mich-j/EMG_HID_mouse/schemat.pdf

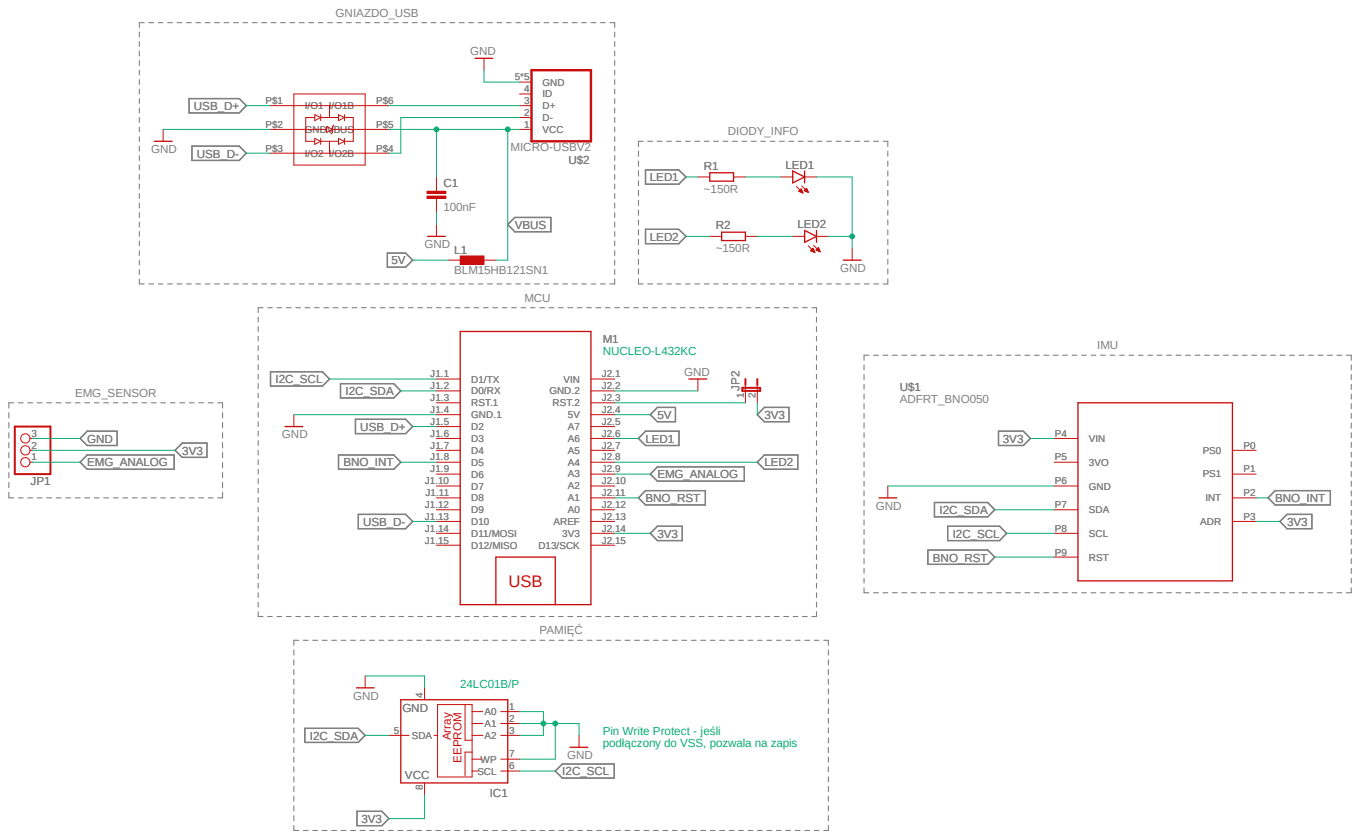
[picture p8: page 1]

Pin Write Protect - jeśli
podłączony do VSS, pozwala na zapis
GND
I2C_SCL
