mich-j/EMG_HID_mouse/PCB.pdf

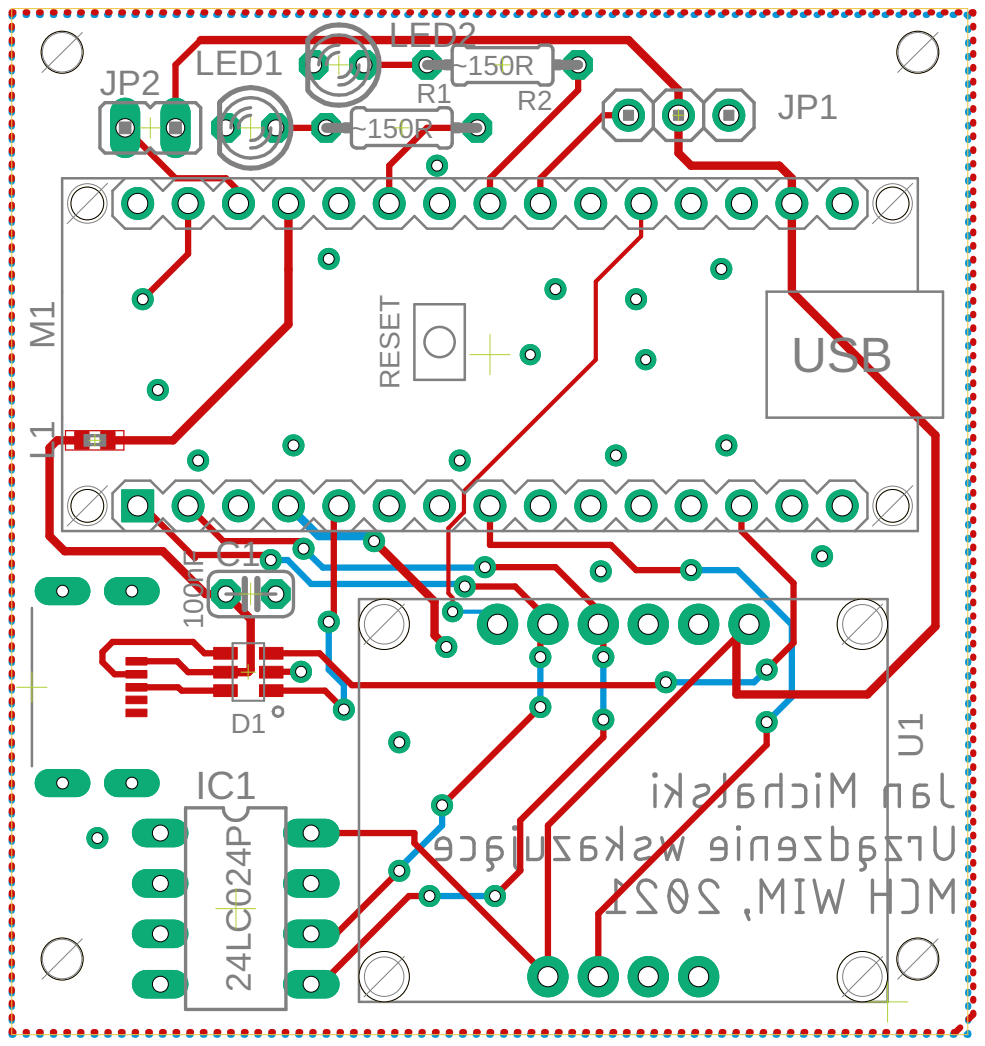
[picture p9: page 1]
