mich-j/EMG_HID_mouse/urz_wskazujace/Core/Inc/main.h

#define MCO_Pin GPIO_PIN_0
#define MCO_GPIO_Port GPIOA
#define BNO_RST_Pin GPIO_PIN_1
#define BNO_RST_GPIO_Port GPIOA
#define VCP_TX_Pin GPIO_PIN_2
#define VCP_TX_GPIO_Port GPIOA
#define INFO_LED_2_Pin GPIO_PIN_5
#define INFO_LED_2_GPIO_Port GPIOA
#define CONFIGMODE_Pin GPIO_PIN_6
#define CONFIGMODE_GPIO_Port GPIOA
#define CONFIGMODE_EXTI_IRQn EXTI9_5_IRQn
#define INFO_LED_1_Pin GPIO_PIN_7
#define INFO_LED_1_GPIO_Port GPIOA
#define SWDIO_Pin GPIO_PIN_13
#define SWDIO_GPIO_Port GPIOA
#define SWCLK_Pin GPIO_PIN_14
#define SWCLK_GPIO_Port GPIOA
#define VCP_RX_Pin GPIO_PIN_15
#define VCP_RX_GPIO_Port GPIOA
#define LD3_Pin GPIO_PIN_3
#define LD3_GPIO_Port GPIOB
#define BNO_INT_Pin GPIO_PIN_6
#define BNO_INT_GPIO_Port GPIOB
