mich-j/EMG_HID_mouse/urz_wskazujace/Core/Inc/BNO_offsets.h

/*
 * BNO_offsets.h
 *
 *  Created on: Nov 14, 2021
 *      Author: koteczeqqq
 */

#ifndef SRC_BNO_OFFSETS_H_
#define SRC_BNO_OFFSETS_H_

/* struktura tabeli:
 * ACC_OFFSET_X_LSB 0x55
 * ACC_OFFSET_X_MSB 0x56
 * ACC_OFFSET_Y_LSB 0x57
 * ACC_OFFSET_Y_MSB 0x58
 * ACC_OFFSET_Z_LSB 0x59
 * ACC_OFFSET_Z_MSB 0x5A
 * MAG_OFFSET_X_LSB 0x5B
 * MAG_OFFSET_X_MSB 0x56C
 * MAG_OFFSET_Y_LSB 0x5D
 * MAG_OFFSET_Y_MSB 0x5E
 * MAG_OFFSET_Z_LSB 0x5F
 * MAG_OFFSET_Z_MSB 0x60
 * GYR_OFFSET_X_LSB 0x61
 * GYR_OFFSET_X_MSB 0x62
 * GYR_OFFSET_Y_LSB 0x63
 * GYR_OFFSET_Y_MSB 0x64
 * GYR_OFFSET_Z_LSB 0x6
 * GYR_OFFSET_Z_MSB 0x66
 *  */

const uint16_t offsets[18] = {0, 0, };







#endif /* SRC_BNO_OFFSETS_H_ */
